Erlansoo/Project_Drone/nubelink/sim/out/S1_escalones.png

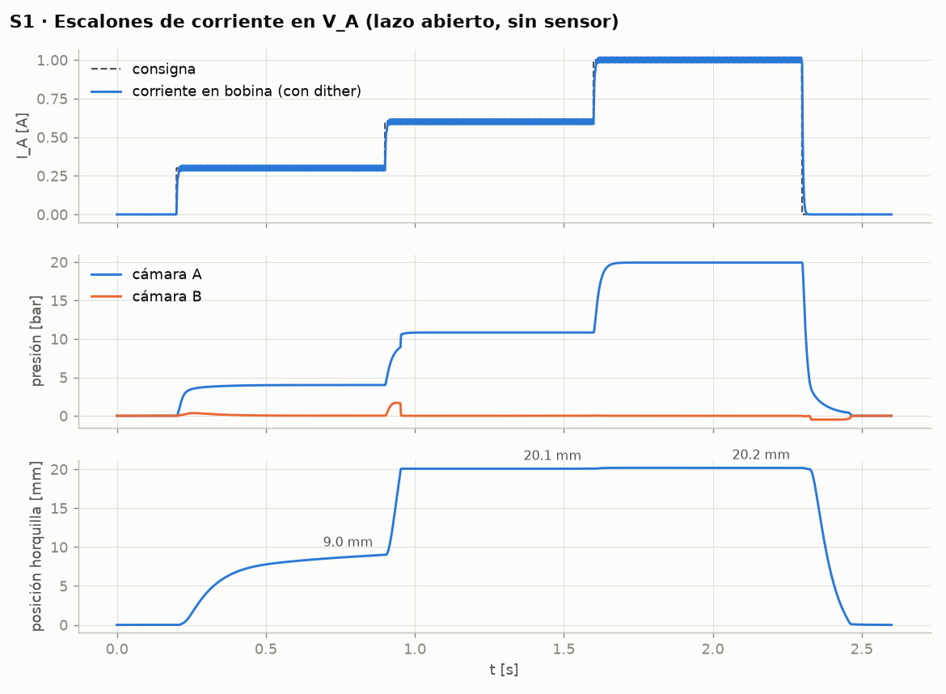
nubelink/sim/out/S1_escalones.png
