Erlansoo/Project_Drone/nubelink/sim/out/S2_histeresis.png

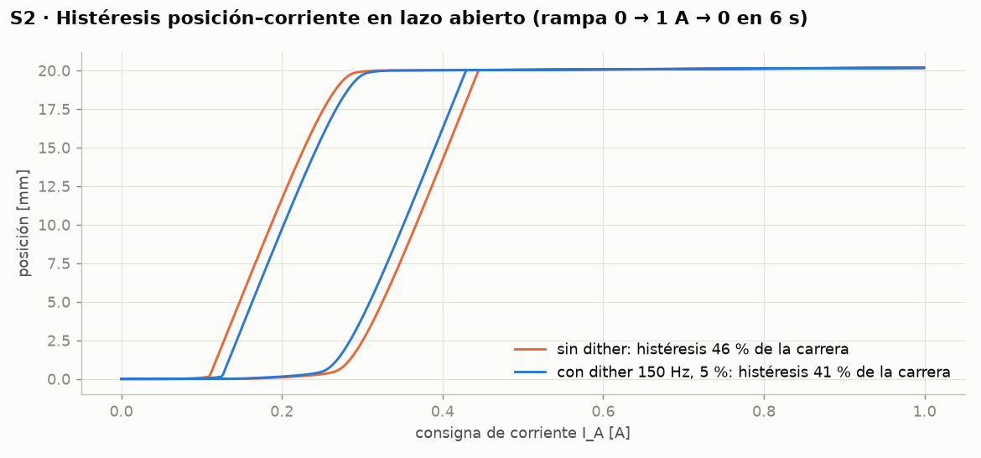
nubelink/sim/out/S2_histeresis.png
