Erlansoo/Project_Drone/nubelink/sim/out/S5_sensibilidad.png

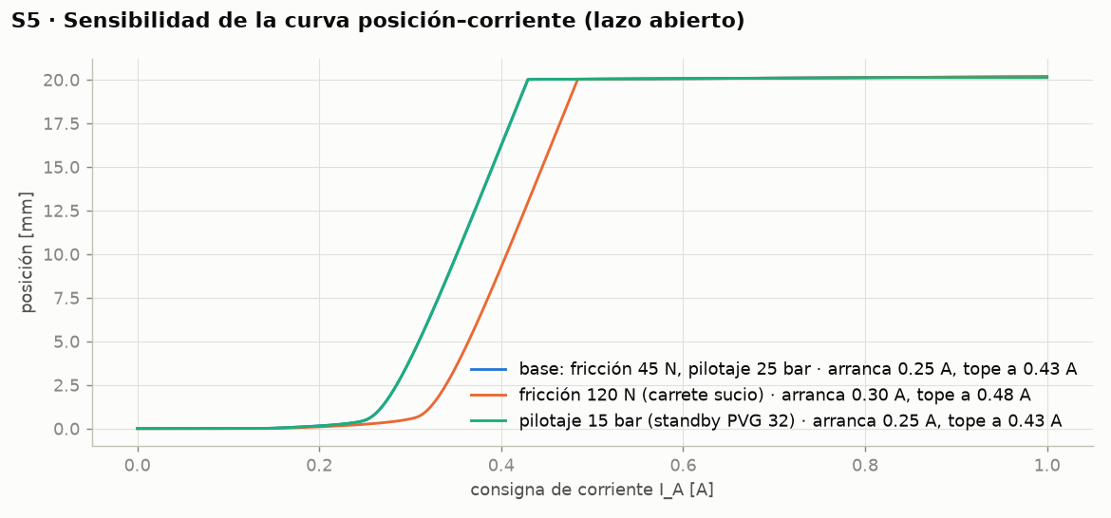
nubelink/sim/out/S5_sensibilidad.png
