Erlansoo/Project_Drone/nubelink/cad/out/nubelink_h1b_comando_ensamble.step

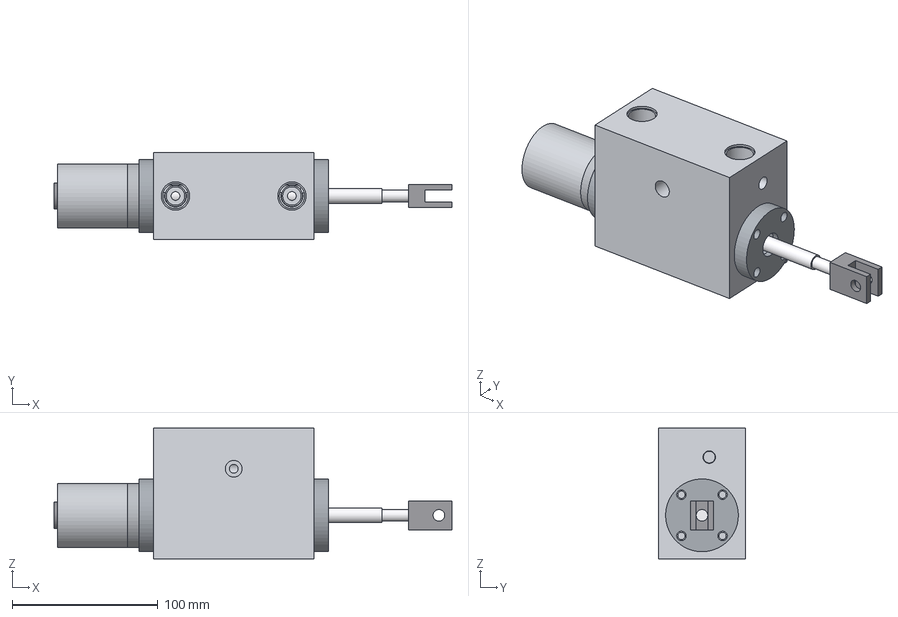
[picture p8: CAD file, 2026-09-28]
nubelink/cad/out/nubelink_h1b_comando_ensamble.step
273.5 x 60.0 x 90.0 mm
bloque
tapa_der
tapa_izq
piston
vastago
horquilla
espaciador
caja_resorte
arandela_1
arandela_2
resorte
collar
tuerca_resorte
