Erlansoo/Project_Drone/nubelink/cad/out/nubelink_h1_ensamble.step

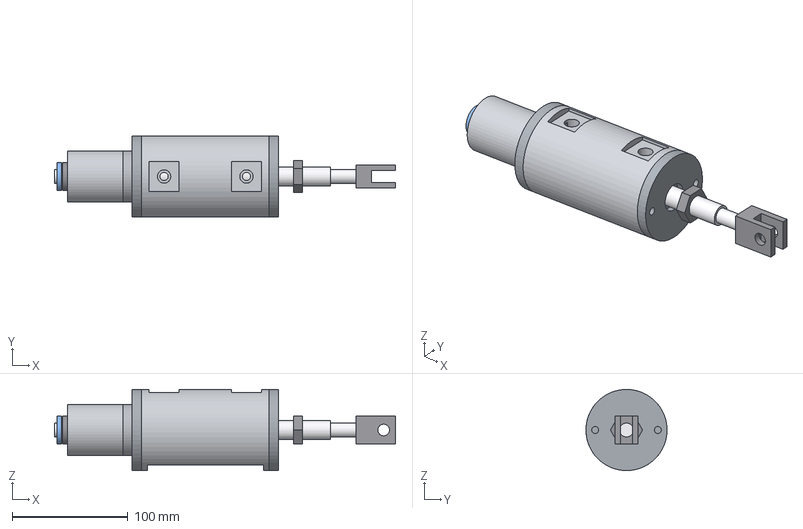
[picture p9: CAD file, 2026-09-28]
nubelink/cad/out/nubelink_h1_ensamble.step
294.0 x 70.0 x 70.0 mm
cuerpo
tapa_der
tapa_izq
piston
vastago
horquilla
tope_der
espaciador
caja_resorte
arandela_1
arandela_2
resorte
collar
tuerca_resorte
porta_iman
