Erlansoo/Project_Drone/nubelink/cad/out/nubelink_h1b_comando_piston.step

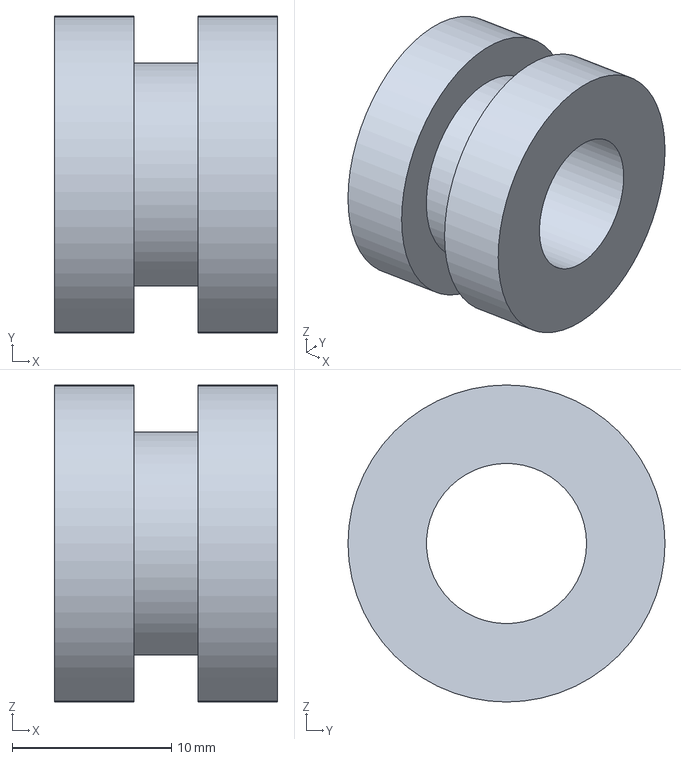
[picture p10: CAD file, 2026-09-28]
nubelink/cad/out/nubelink_h1b_comando_piston.step
14.0 x 19.9 x 19.9 mm
