Erlansoo/Project_Drone/nubelink/cad/out/nubelink_h1b_comando_tapa.step

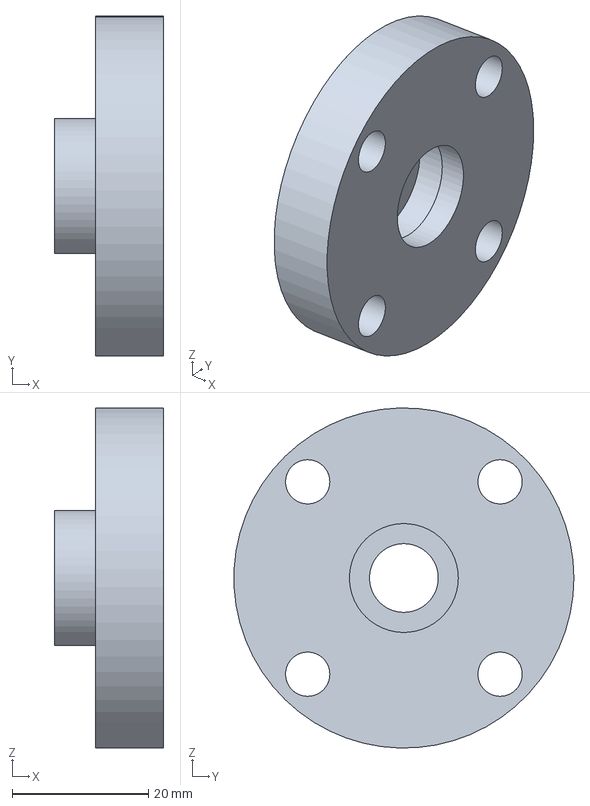
[picture p11: CAD file, 2026-09-28]
nubelink/cad/out/nubelink_h1b_comando_tapa.step
16.0 x 50.0 x 50.0 mm
