Erlansoo/Project_Drone/nubelink/cad/out/nubelink_h1b_comando_vastago.step

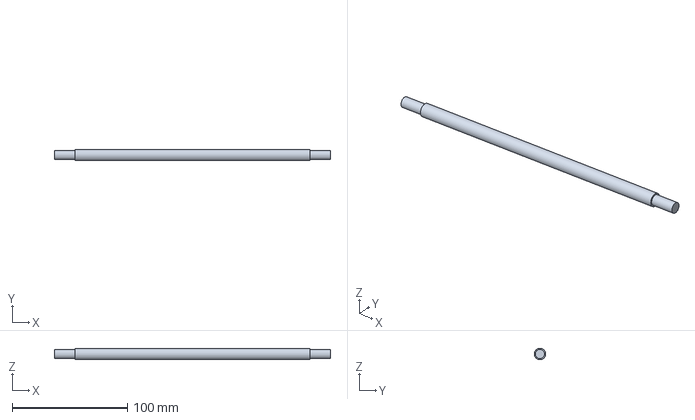
[picture p12: CAD file, 2026-09-28]
nubelink/cad/out/nubelink_h1b_comando_vastago.step
240.0 x 9.99 x 10.00 mm
