Erlansoo/Project_Drone/nubelink/cad/out/nubelink_h1b_comando_bloque.step

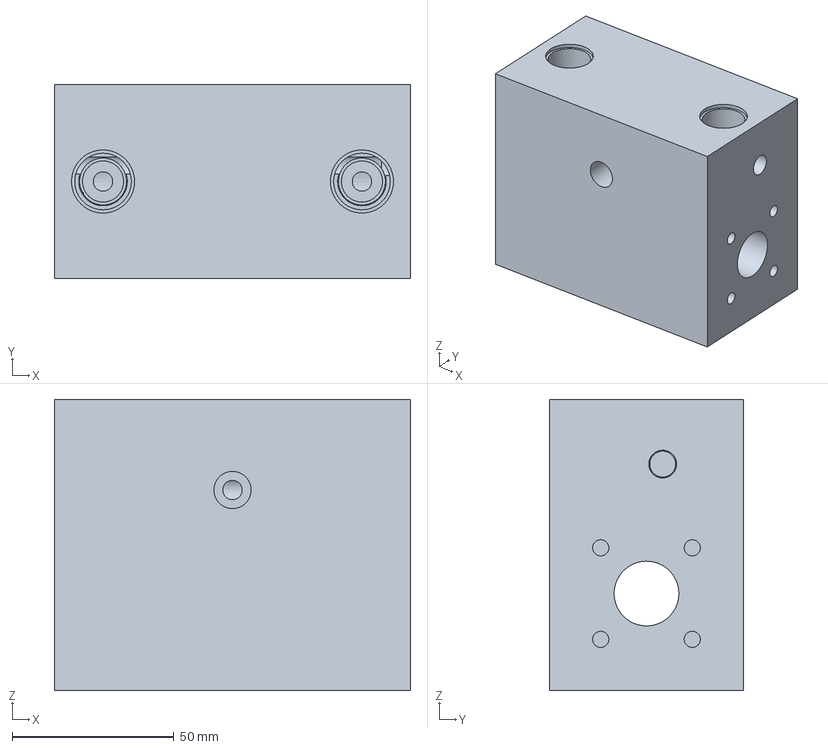
[picture p13: CAD file, 2026-09-28]
nubelink/cad/out/nubelink_h1b_comando_bloque.step
110.0 x 60.0 x 90.0 mm
