Erlansoo/Project_Drone/nubelink/cad/out/nubelink_h1b_comando_horquilla.step

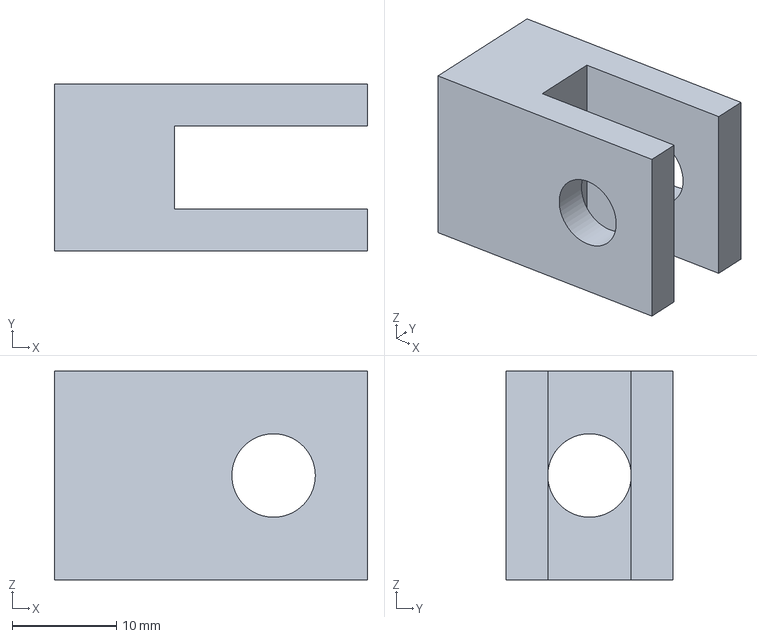
[picture p15: CAD file, 2026-09-28]
nubelink/cad/out/nubelink_h1b_comando_horquilla.step
30.0 x 16.0 x 20.0 mm
