Erlansoo/Project_Drone/nubelink/cad/out/nubelink_h1_piston.step

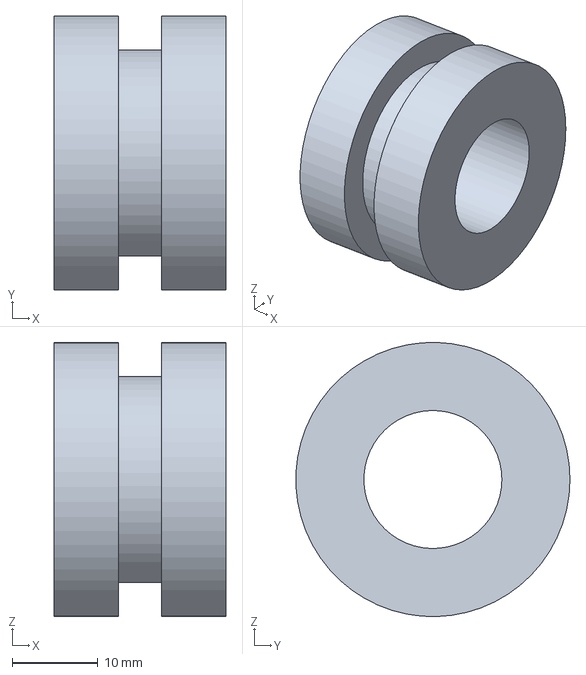
[picture p16: CAD file, 2026-09-28]
nubelink/cad/out/nubelink_h1_piston.step
20.0 x 31.9 x 31.9 mm
