Erlansoo/Project_Drone/nubelink/cad/out/nubelink_h1_cuerpo.step

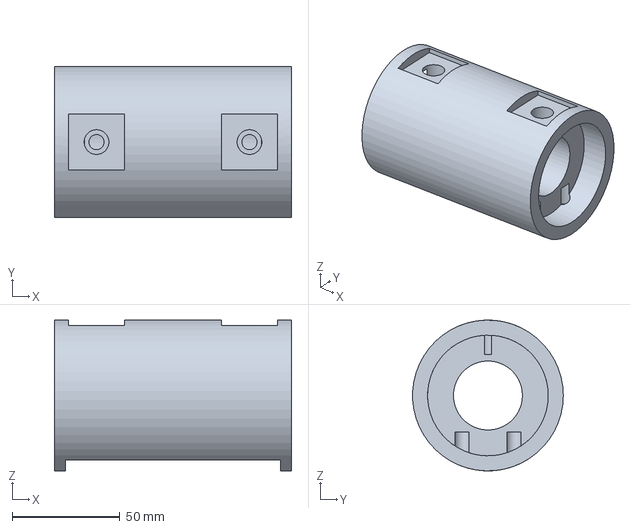
[picture p17: CAD file, 2026-09-28]
nubelink/cad/out/nubelink_h1_cuerpo.step
110.0 x 69.9 x 70.0 mm
