Erlansoo/Project_Drone/nubelink/cad/out/nubelink_h1_horquilla.step

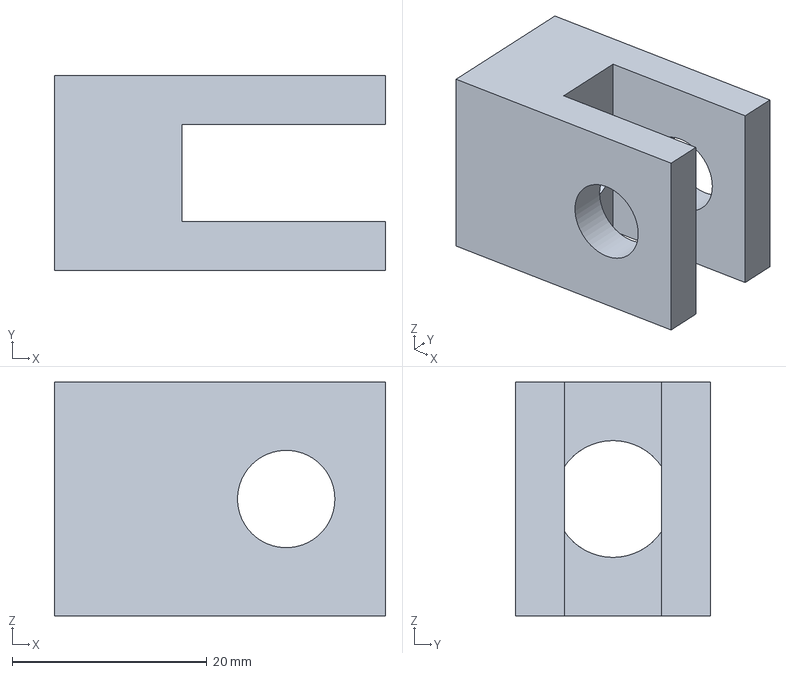
[picture p18: CAD file, 2026-09-28]
nubelink/cad/out/nubelink_h1_horquilla.step
34.0 x 20.0 x 24.0 mm
