Erlansoo/Project_Drone/nubelink/cad/out/nubelink_h1_tapa.step

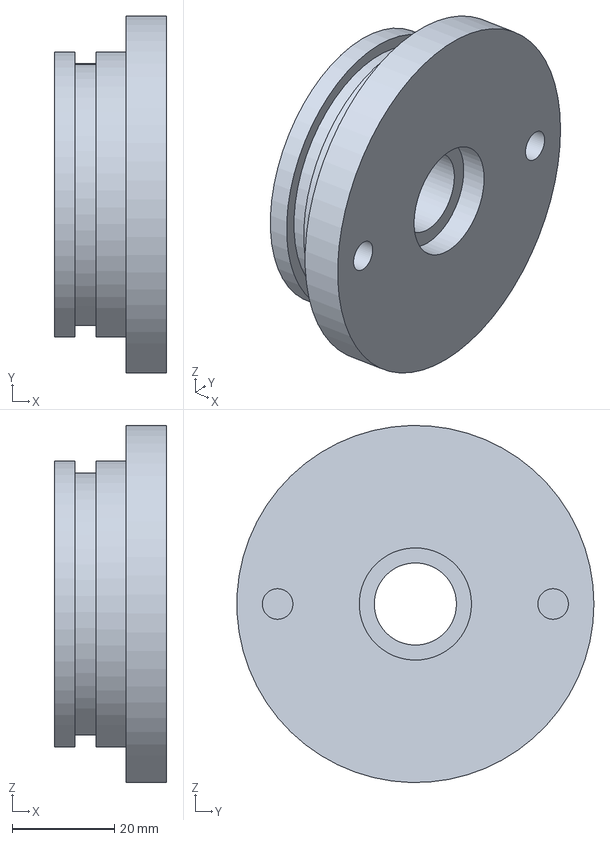
[picture p19: CAD file, 2026-09-28]
nubelink/cad/out/nubelink_h1_tapa.step
22.0 x 70.0 x 70.0 mm
