Erlansoo/Project_Drone/nubelink/cad/out/nubelink_h1_caja_resorte.step

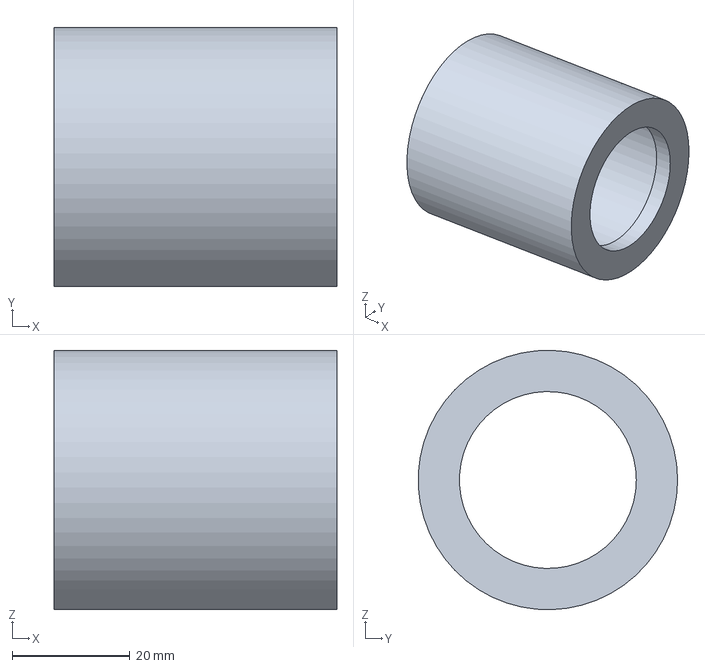
[picture p20: CAD file, 2026-09-28]
nubelink/cad/out/nubelink_h1_caja_resorte.step
48.0 x 44.0 x 44.0 mm
