Erlansoo/Project_Drone/nubelink/cad/out/nubelink_h1_vastago.step

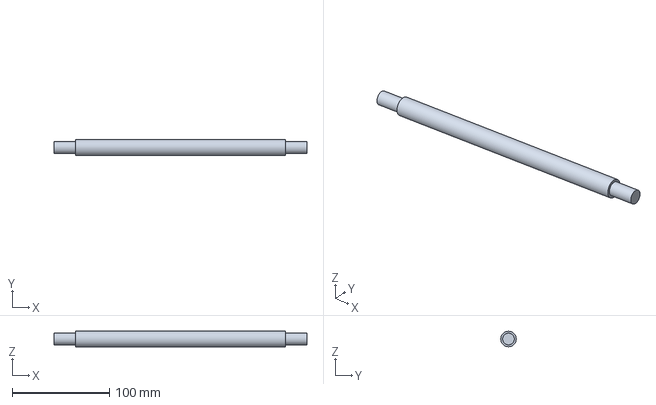
[picture p21: CAD file, 2026-09-28]
nubelink/cad/out/nubelink_h1_vastago.step
260.0 x 16.0 x 16.0 mm
