Erlansoo/Project_Drone/nubelink/cad/out/nubelink_h1_bloque_valvulas.step

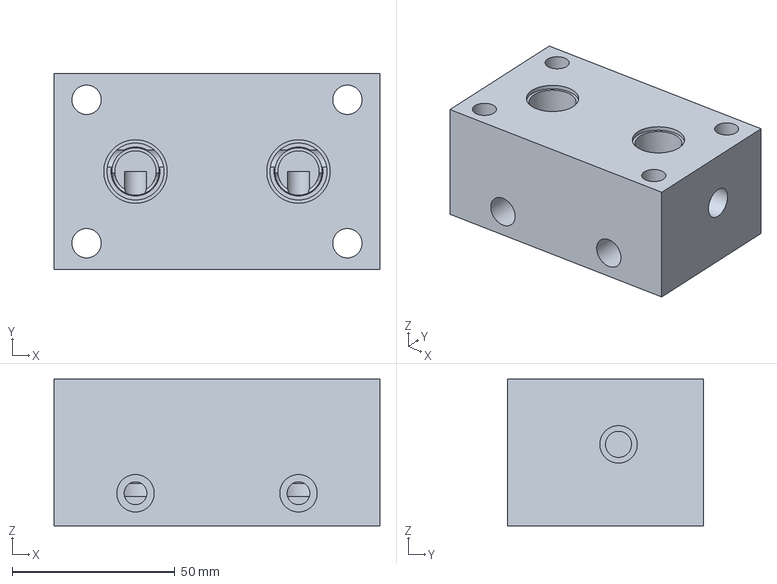
[picture p22: CAD file, 2026-09-28]
nubelink/cad/out/nubelink_h1_bloque_valvulas.step
100.0 x 60.0 x 45.0 mm
