Erlansoo/Project_Drone/(list of files, cad)

Other CAD files:
nubelink/cad/out/nubelink_h1_bloque_valvulas.stl
nubelink/cad/out/nubelink_h1_cuerpo.stl
nubelink/cad/out/nubelink_h1b_comando_bloque.stl
