Erlansoo/Project_Drone/(commit log)

2026-09-28 Nubelink: análisis del Scanreco MOD10 y especificación del prototipo H1
    Carpeta de ingeniería para el bloque servohidráulico que permite
    radiocontrolar grúas con distribuidor manual:
    - docs/nubelink_h1_analisis_y_especificacion.md: hallazgos sobre el MOD10
    (30 bar, 1300 N, ±13/±20 mm, dos reductoras proporcionales por función,
    bloque de contrapresión), principio de funcionamiento, arquitectura,
    especificación del servopistón H1, válvulas candidatas, fabricación,
    seguridad, protocolo de ensayos, costos y hoja de ruta.
    - docs/esquema_hidraulico_h1.svg: esquema de un módulo con alimentación
    de pilotaje (contrapresión, reductora, filtro, dump, alivio).
    - cad/nubelink_h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
    [nubelink_h1_cuerpo.step, nubelink_h1_cuerpo.stl, nubelink_h1_ensamble.step, nubelink_h1_horquilla.step, nubelink_h1_piston.step, nubelink_h1_tapa.step, nubelink_h1_vastago.step]
2026-09-28 Nubelink: diseño del sistema completo y paridad de empuje con el MOD10
    - Servopistón H1 redimensionado a camisa Ø32 / vástago Ø16 (603 mm²):
    1 206 N a 20 bar y 1 508 N a 25 bar, carrera ±20 mm con topes para
    ±13 mm; cuerpo Ø70 x 110, tapas M56x1,5. CAD y STEP regenerados.
    - Nuevo modelo del bloque de válvulas de aluminio (2 cavidades FC08-3
    para HYDAC PDR08-01, galerías P/T sin tapones, salidas A/B G1/4).
    - Documento: sección 4A "Diseño del sistema completo" con la cadena
    entrada G3/4 -> contrapresión venteada -> reductora -> filtro ->
    bloque de válvulas -> servopistón, tabla de alimentación piloto según
    distribuidor (Hiab V80/V91, Danfoss PVG 32), qué se fabri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
    [nubelink_h1_bloque_valvulas.step, nubelink_h1_bloque_valvulas.stl, nubelink_h1_cuerpo.step, nubelink_h1_cuerpo.stl, nubelink_h1_ensamble.step, nubelink_h1_horquilla.step, nubelink_h1_piston.step, nubelink_h1_tapa.step]
2026-09-28 Nubelink: simulación dinámica, guía de herramientas/compras y resorte de centrado
    - sim/servopiston_model.py (+ gemelo .m): modelo de parámetros concentrados
    del módulo (válvulas reductoras proporcionales, cámaras con compresibilidad,
    pistón Ø32/Ø16, resorte del carrete, resorte propio opcional, fricción,
    lazo de corriente con dither, PI de posición, corte de pilotaje/control).
    - sim/run_scenarios.py: 7 escenarios con figuras y resumen (sim/out/).
    Hallazgos: el lazo abierto satura a 0,3 A con ~50 % de histéresis; con
    sensor y PI posiciona a ±0,5 mm en < 100 ms; el retorno a neutro exige
    la secuencia "retorno activo -> dump" y un paquete de resorte propio
    (60 N + 2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
    [nubelink_h1_caja_resorte.step, nubelink_h1_cuerpo.step, nubelink_h1_ensamble.step, nubelink_h1_horquilla.step, nubelink_h1_piston.step, nubelink_h1_tapa.step, nubelink_h1_vastago.step]
2026-09-28 Nubelink: resorte de centrado obligatorio y cadena PWM -> posición
    - Modelo (Python y MATLAB): resorte de centrado propio por defecto
    (50 N + 2,5 N/mm). Nuevo escenario S7: recorrido del pistón vs. señal
    PWM del joystick en lazo cerrado (proporcional, desvío < 2 mm) y en lazo
    abierto (histéresis 30-40 %). Tabla de fuerza en modo manual según
    resorte y fricción.
    - Documentos: sección 4.3 "Cadena de señal" (PWM de mando vs PWM de
    potencia, bobina 24 V controlada en corriente con alimentación 20-30 V,
    un sentido por válvula, dónde vive el lazo), resorte obligatorio en la
    especificación y en el CAD, resultados re-sincronizados.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
2026-09-28 Nubelink H1-B: comando integrado para lazo abierto y hoja de fabricación
    - sim/estudio_lazo_abierto.py: estudio paramétrico pistón x resorte propio x
    sellos x distribuidor para la versión en lazo abierto (corriente ∝ PWM).
    Elección: Ø20/Ø10, resorte 40 N + 6 N/mm, sellos PTFE, PDR08-01 0-20 bar
    (histéresis 7-17 %, banda 0,30-0,85 A, ~60 N extra en la empuñadura).
    - cad/nubelink_h1b_comando.py: bloque integrado de una función 110x60x90
    (camisa Ø20 H8, 2 cavidades FC08-3, galerías P/T con tapones G1/8,
    salidas A/B internas, puertos G1/4, tapas atornilladas 4xM6, resorte de
    centrado, horquilla). STEP/STL/SVG en cad/out.
    - docs/hoja_fabricacion_h1b.md: cotas, tolerancia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
    [nubelink_h1b_comando_bloque.step, nubelink_h1b_comando_bloque.stl, nubelink_h1b_comando_caja_resorte.step, nubelink_h1b_comando_ensamble.step, nubelink_h1b_comando_horquilla.step, nubelink_h1b_comando_piston.step, nubelink_h1b_comando_tapa.step, nubelink_h1b_comando_vastago.step]
